lingjiawang511/printer_tag_device/WL1800-E-D001-PrinterC Rev.2.0 位号清单.xls

WL1800-E-D001-PrinterC Rev.2.0 位号清单
序号 | 封装 | 名称 | 数量 | 位号
1 | 0805 | 0.1uF(104) | 65 | C4, C9, C10, C11, C20, C33,C34, C35, C38, C39, C40, C41,C42,C45, C46, C48, C51, C53, C54,C55,C56, C57, C58, C59, C60, C61,C62,C63, C64, C65, C66, C67, C74,C75,C76, C77, C79, C81, C82, C83, C84, C86 (正面) C2, C6, C30, C31, C32,C36,C37, C43, C44, C47, C49, C50,C52,C68, C69, C70, C71, C72, C73, C78, C80, C85, C87 （背面）
2 | 0805 | 20pF | 2 | C12, C13
3 | 0805 | 1K | 20 | R2, R3, R14, R16, R24, R25, R27, R33, R52, R54, R64, R66, R68, R74, R77, R78, R81, R82, R85, R86
4 | 0805 | 2.2K | 30 | R13, R15, R17, R22, R23, R26, R32, R34, R40, R42, R44, R46, R49, R50, R51, R53, R63, R65, R67, R73, R75, R76, R79, R80, R83, R84, R87, R92, R95, R100
5 | 0805 | 10K | 45 | R1, R4, R6, R7, R18, R19, R20, R21, R28, R29, R30, R31, R36, R41, R43, R45, R47, R55, R56, R57, R58, R59, R60, R61, R62, R69, R70, R71, R72, R88, R89, R90, R91, R93, R94, R96, R97, R98, R99, R101, R102(正面) R35, R37, R38, R39（背面）
6 | 0805 | 220R | 1 | R48
7 | 0805 | 1M | 1 | R5
8 | 0805 | LED红 | 2 | LED1,LED2
9 | 0805 | LED绿 | 1 | LED4
10 | 直插 | 自恢复保险丝 C30UF500 | 1 | F1
11 | DO-214AC | SS34 | 2 | D3, D4
12 | 直插电容 | 470uF/35V | 1 | C3
13 | 直插电容 | 2200uF/35V | 1 | C1
14 | A壳 | 10uF(106C)/16v | 4 | C8, C22（正面） C5, C7（背面）
15 | SO14 | 74HC10 | 1 | U19
16 | SOP8 | LM293 | 8 | U11, U15, U21, U22, U24, U33, U34（正面） 'U17（背面）
17 | 直插 | 8MHZ无源晶振 | 1 | Y1
18 | 贴片 | 隔离电源B2405XT-2WR2 | 1 | U1
19 | SOT-223 | AMS1117-3.3 | 1 | U2（背面）
20 | SOP8 | CEM4435A | 10 | U27（正面） U8, U10, U12, U13, U25, U26, U28, U30, U31（背面）
21 | SOP16 | 光耦TLP280-4 | 8 | U9, U14, U16, U18, U20, U23, U29, U32
22 | 直插 | 有人K3网络模块 | 1 | U5
23 | LQFP-48 | STM32F103RCT6 | 1 | U3
24 | TO252 | FR5305 | 1 | Q1（背面）
25 | TO252 | FR4105 | 1 | Q2（背面）
26 | DIP-1.50 | 4PIN直角插座 | 1 | JP1
27 | 直插 | VH3.96-4PIN | 4 | CH1, CH4, CH5, CH11
28 | 直插 | VH3.96-3PIN | 7 | CH6, CH7, CH8, CH14, CH15, CH16, CH17
29 | 直插 | VH3.96-2PIN | 3 | CH9, CH10, CH13
30 | 直插 | VH3.96-6PIN | 3 | CH3, CH12, CH18
31
32
33
 |  |  | 228
