lingjiawang511/printer_tag_device/BOM For Me.xlsx

Sheet: BOM Report
Bill of Materials |  |  | Field=Title
Source Data From: |  | Field=DataSourceFileName
Project: |  | Field=ProjectFileName
Variant: |  | Field=VariantName
Creation Date: | Field=ReportDate | Field=ReportTime
Print Date: | 2017-03-17 | 17:10:34
Item # | Column=Footprint | Column=Comment | Column=Designator | Column=Value | Column=Quantity
1
2
3
 |  |  |  |  | 0
Approved |  | Notes

Sheet: Project Information
Project Full Path | Field=ProjectFullPath
Project Filename | Field=ProjectFileName
Variant Name | Field=VariantName
Data-Source Filename | Field=DataSourceFileName
Data-Source Full Path | Field=DataSourceFullPath
Title | Field=Title
Total Quantity | Field=TotalQuantity
Report Time | Field=ReportTime
Report Date | Field=ReportDate
Report Date & Tine | Field=ReportDateTime
Output Name | Field=OutputName
Output Type | Field=OutputType
Output Generator Name | Field=GeneratorName
Output Generator Description | Field=GeneratorDescription
