lingjiawang511/printer_tag_device/hardware/printer_tag_device.xlsx

Sheet: BOM Report
Bill of Materials |  |  | Bill of Materials For Project [printer_tag_device.PrjPCB] (No PCB Document Selected)
Source Data From: |  | printer_tag_device.PrjPCB
Project: |  | printer_tag_device.PrjPCB
Variant: |  | None
Creation Date: | 2017/4/10 | 11:05:41
Print Date: | 2017-04-10 | 11:05:48
Item # | Footprint | Comment | Designator | Value | Quantity
1 | C7.8*17 | C_2200uF | C1 |  | 1
2 | 0805 | Cap | C2, C4, C6, C20, C30, C31, C35, C36, C37, C38, C39, C40, C41 | 0.1uF | 13
3 | C5*10 | C_2200uF | C3 |  | 1
4 | CAP A-3216 | Cap Pol3 | C5, C7, C8, C22 | 10uF/16V(106C) | 4
5 | 0805 | Cap | C9, C10, C11, C32, C33, C34, C42, C43, C44, C45, C46, C47, C48, C49, C50, C51, C52, C53, C54, C55, C56, C57, C58, C59, C60, C61, C62, C63, C64, C65, C66, C67, C68, C69, C70, C71, C72, C73, C74, C75, C76, C77, C78, C79, C80, C81, C82, C83, C84, C85, C86, C87 | 104 | 52
6 | 0805 | Cap | C12, C13 | 20pF | 2
7 | CH3.96-4PIN | HEADER1X4 | CH1, CH4, CH5, CH11 |  | 4
8 | CH3.96-6PIN | HEADER1X6 | CH3, CH12, CH18 |  | 3
9 | CH3.96-3PIN | HEADER1X3 | CH6, CH7, CH8, CH14, CH15, CH16, CH17 |  | 7
10 | CH3.96-2PIN | HEADER1X2 | CH9, CH10, CH13 |  | 3
11 | SMA | 1N5822(SS34) | D3, D4 |  | 2
12 | X30UF600 | X30_UF500 | F1 |  | 1
13 | CON4_1.5 | 4 HEADER | JP1 |  | 1
14 | LED-0805 |  | LED1, LED2 |  | 2
15 | LED-0805 | Ready | LED4 |  | 1
16 | pad35 | Pad | Pad1, Pad2, Pad3, Pad4 |  | 4
17 | TO-252 | FR5305 (PMOS-2) | Q1 |  | 1
18 | TO-252 | FR4105 (NMOS-2) | Q2 |  | 1
19 | 0805 | Res2 | R1, R4, R6, R7, R18, R19, R20, R21, R28, R29, R30, R31, R35, R36, R37, R38, R39, R41, R43, R45, R47, R55, R56, R57, R58, R59, R60, R61, R62, R69, R70, R71, R72, R88, R89, R90, R91, R93, R94, R96, R97, R98, R99, R101, R102 | 10K | 45
20 | 0805 | Res2 | R2, R3, R14, R16, R24, R25, R27, R33, R52, R54, R64, R66, R68, R74, R77, R78, R81, R82, R85, R86 | 1K | 20
21 | 0805 | Res2 | R5 | 1M | 1
22 | 0805 | Res2 | R13, R15, R17, R22, R23, R26, R32, R34, R40, R42, R44, R46, R49, R50, R51, R53, R63, R65, R67, R73, R75, R76, R79, R80, R83, R84, R87, R92, R95, R100 | 2.2K | 30
23 | 0805 | Res2 | R48 | 200R | 1
24 | B2405XT-2WR2 | B2405XT-2WR2 | U1 |  | 1
25 | SOT223 | AMS1117-3.3 | U2 |  | 1
26 | LQFP64 | STM32F103RBT6 | U3 |  | 1
27 | USR-K3 | USR-K3 | U5 |  | 1
28 | SOP8-OP27 | CEM4435A | U8, U10, U12, U13, U25, U26, U27, U28, U30, U31 |  | 10
29 | SO16 | TLP280-4 | U9, U14, U16, U18, U20, U23, U29, U32 |  | 8
30 | SOP8-OP27 | LM293 | U11, U15, U17, U21, U22, U24, U33, U34 |  | 8
31 | SO14 | 74HC10 | U19 |  | 1
32 | XTAL_US | 8MHz | Y1 |  | 1
 |  |  |  |  | 232
Approved |  | Notes

Sheet: Project Information
Project Full Path | G:\program\printer_tag_device\hardware\printer_tag_control\printer_tag_device.PrjPCB
Project Filename | printer_tag_device.PrjPCB
Variant Name | None
Data-Source Filename | printer_tag_device.PrjPCB
Data-Source Full Path | G:\program\printer_tag_device\hardware\printer_tag_control\printer_tag_device.PrjPCB
Title | Bill of Materials For Project [printer_tag_device.PrjPCB] (No PCB Document Selected)
Total Quantity | 232
Report Time | 11:05:41
Report Date | 2017/4/10
Report Date & Tine | 2017/4/10 11:05:41
Output Name | Bill of Materials
Output Type | BOM_PartType
Output Generator Name | BOM
Output Generator Description | Bill of Materials
