lingjiawang511/printer_tag_device/(list of files, drawings)

Other design files:
hardware/printer_tag_control/air_cylinder_control.SchDoc
hardware/printer_tag_control/belt_motor_control.SchDoc
hardware/printer_tag_control/communition.SchDoc
hardware/printer_tag_control/cpu.SchDoc
hardware/printer_tag_control/light_key_control.SchDoc
hardware/printer_tag_control/power.SchDoc
hardware/printer_tag_control/printer_control.SchDoc
hardware/printer_tag_control/printer_tag_device.PcbDoc
hardware/printer_tag_control/printer_tag_device.PrjPCB
hardware/printer_tag_control/printer_tag_device.SchDoc
hardware/printer_tag_control/roll_motorl_control.SchDoc
hardware/printer_tag_control/WL1800-E-D001-PrinterC Rev.2.0.PcbDoc
hardware/printer_tag_control/WL1800-E-D001-PrinterC Rev.2.0.PrjPCB
hardware/printer_tag_control/WL1800-E-D001-PrinterC Rev.2.0.SchDoc
