lingjiawang511/printer_tag_device/printer_mcu/include/flash.h

#ifndef __STMFLASH_H__
#define __STMFLASH_H__
#include "stm32f10x.h"

//FLASH起始地址
#define STM32_FLASH_BASE 			0x08000000     //STM32 FLASH的起始地址
#define FLASH_START_ADDR    	0X08000000
#define APP_OFFSET 					  (0x4000)		
#define FLASH_SAVE_SIZE 			(0X5000)

//用户根据自己的需要设置
#define STM32_FLASH_SIZE 512 	 		//所选STM32的FLASH容量大小(单位为K)
#define STM32_FLASH_WREN 1              //使能FLASH写入(0，不是能;1，使能)
//////////////////////////////////////////////////////////////////////////////////////////////////////

 

u16 STMFLASH_ReadHalfWord(u32 faddr);		  //读出半字  
void STMFLASH_WriteLenByte(u32 WriteAddr,u32 DataToWrite,u16 Len);	//指定地址开始写入指定长度的数据
u32 STMFLASH_ReadLenByte(u32 ReadAddr,u16 Len);						//指定地址开始读取指定长度数据
FLASH_Status STMFLASH_Write(u32 WriteAddr,u16 NumToWrite,u16 *pBuffer);		//从指定地址开始写入指定长度的数据
void STMFLASH_Read(u32 ReadAddr,u16 *pBuffer,u16 NumToRead);   		//从指定地址开始读出指定长度的数据

//测试写入
void Test_Write(u32 WriteAddr,u16 WriteData);								   
#endif
