lingjiawang511/printer_tag_device/printer_mcu/include/usart.h

#ifndef __USART_H
#define __USART_H

#include "stm32f10x.h"
#include "stdio.h"

void USART1_IRQHandler(void);	
int fputc(int ch, FILE *f);
void USART1_Putc(unsigned char c);
void USART1_Puts(char * str);
void USART1_Config(void);
void USART2_Config(void);
void USART2_Putc(unsigned char c);
void USART2_Puts(char * str);
void USART3_Config(void);
void USART3_Putc(unsigned char c);
void USART3_Puts(char * str);

void USART1_Do_Tx(void );
void USART2_Do_Tx(void );
void USART3_Do_Tx(void );
void USART1_Do_Rx(u8 rxdata);
void USART2_Do_Rx(u8 rxdata);
void USART3_Do_Rx(u8 rxdata);

#endif
