lingjiawang511/printer_tag_device/(commit log)

2017-01-23 Init Signed-off-by: lingjiawang511 <398677675@qq.com>
    [air_cylinder_control.SchDoc, belt_motor_control.SchDoc, communition.SchDoc, cpu.SchDoc, light_key_control.SchDoc, power.SchDoc, printer_control.SchDoc, printer_tag_device.PcbDoc]
2017-01-23 fix the hardware
    [cpu.SchDoc, printer_tag_device.PrjPCB]
2017-02-17 fix the hardware sch and pcb
    [air_cylinder_control.SchDoc, belt_motor_control.SchDoc, communition.SchDoc, cpu.SchDoc, light_key_control.SchDoc, power.SchDoc, printer_control.SchDoc, printer_tag_device.PcbDoc]
2017-02-17 fix the hardware with delete the nouse file
    [printer_tag_device1.PcbDoc]
2017-02-17 fix the hardware PCB
    [air_cylinder_control.SchDoc, belt_motor_control.SchDoc, cpu.SchDoc, light_key_control.SchDoc, printer_control.SchDoc, printer_tag_device.PcbDoc, roll_motorl_control.SchDoc]
2017-02-22 hardware: fix the sch and PCB
    [communition.SchDoc, cpu.SchDoc, printer_tag_device.PcbDoc]
2017-02-22 hardware: fix the PCB
    [printer_tag_device.PcbDoc]
2017-02-23 software:fix the program project
    [HeadType.h, LOCK.C, TIM.C, beep.c, beep.h, belt.c, belt.h]
2017-02-27 software: printer program and the test program
2017-03-01 software and hardware: fix the roll paper control and the light and key control
    [belt_motor_control.SchDoc, printer_tag_device.PcbDoc, roll_motorl_control.SchDoc]
2017-03-02 printer software:fix the the printer and the air cylinder program
    [HeadType.h, air_cylinder.c, air_cylinder.h, exti.c, main.c, printer.h]
2017-03-02 printer software: add the communication program
2017-03-07 printer software: fix the printer control and the air control
    [LOCK.C, TIM.C, air_cylinder.c, air_cylinder.h, baffle.c, beep.c, belt.c, communication.c]
2017-03-08 printer software: fix the printer and air cylinder and the device and the light
    [HeadType.h, air_cylinder.c, belt.h, exti.c, key_and_light.c, main.c, roll_paper.c]
2017-03-08 printer software: add the project file
2017-03-08 software: printer and scanner update the communication program and fix the scanner USR file
    [HeadType.h, LOCK.C, TIM.C, air_cylinder.c, baffle.c, beep.c, belt.c, communication.c]
2017-03-08 scanner software: fix the baffle program
    [HeadType.h, baffle.c, baffle.h, main.c]
2017-03-08 hardware: fix the hardware sch and PCB
    [air_cylinder_control.SchDoc, printer_tag_device.PcbDoc, printer_tag_device.PrjPCB]
2017-03-15 printer software: add the printer program
    [printer_tag_device.PrjPCB]
2017-03-15 printer software: fix the key and the communication
    [HeadType.h, air_cylinder.c, baffle.h, belt.h, key_and_light.c, main.c]
2017-03-15 printer software:fix the baffle control
    [baffle.c]
2017-03-16 printer software:fix the key starting mode and the err mode
    [baffle.c, key_and_light.c]
2017-03-16 printer software: fix the device mode for the err
    [key_and_light.c, main.c, roll_paper.c]
2017-03-16 add the Altium designer BOM FOR ME
    [BOM For Me.xlsx, printer_tag_device.PcbDoc, printer_tag_device.PrjPCB]
2017-03-17 printer software: fix the communication program with add the communication protocol
    [HeadType.h, baffle.c, communication.c, exti.c, main.c]
2017-03-20 printer software: fix the communication and the baffle program
    [BOM For Me.xlsx]
2017-03-20 printer software: fix the baffle control and add the err message
    [baffle.c, main.c]
2017-03-21 printer :add the communication protocol manual
2017-04-06 printer software:fix the communication
    [cpu.SchDoc, printer_tag_device.PcbDoc, printer_tag_device.PrjPCB]
2017-04-07 printer software: fix the scanner err time mode
    [baffle.c]
2017-04-07 printer software: fix the baffle control
    [baffle.c, communication.c]
2017-04-10 hardware: remove the cpu2 and the rs232 communication,and fix the PCB
    [communition.SchDoc, cpu.SchDoc, printer_tag_device.PcbDoc, printer_tag_device.PrjPCB, printer_tag_device.xlsx]
2017-04-10 hardware: fix the PCB and add the BOM
    [WL1800-E-D001-PrinterC Rev.2.0 位号清单.xls, WL1800-E-D001-PrinterC Rev.2.0.PcbDoc, WL1800-E-D001-PrinterC Rev.2.0.PrjPCB, WL1800-E-D001-PrinterC Rev.2.0.SchDoc, WL1800-E-D001-PrinterC Rev.2.0.xlsx, air_cylinder_control.SchDoc, belt_motor_control.SchDoc, communition.SchDoc]
2017-06-02 add some file
    [WL1800-E-D001-PrinterC Rev.2.0.PcbDoc]
2017-06-06 printer software: fix the baffle sensor detection program
    [baffle.c, key_and_light.c]
2017-06-06 printer software:mask the baffle sensor control
    [roll_motorl_control.SchDoc]
2017-06-08 printer software: add the file which it is dispose fault and fix the baffle control
    [baffle.c]
2017-08-16 printer software: add the air_cylinder up err program
2017-11-24 software:add the printer restart signal control the roll paper motor
2018-01-10 software:fix the roll paper run delay
    [HeadType.h, air_cylinder.c, roll_paper.c]
2018-02-28 software: fix the exit pull dowm resistance
    [baffle.c, exti.c]
2018-02-28 software:reset the exit pull dowm resistance to pull up
    [exti.c]
2018-03-01 software:fix the printer err stop mode with the continuous three times
    [air_cylinder.c, exti.c]
2018-03-14 software:fix the baffle control logic with the PC control
    [HeadType.h, baffle.c]
2018-05-08 software:add the baffle ERR stop belt motor
2018-11-29 fix the sensor irq filter time
    [exti.c]
2018-12-27 add the light indicate device error state
    [key_and_light.c]
2019-01-13 software: fix the light indicate device error state
    [air_cylinder.c, key_and_light.c]
2019-05-07 software:add the roll paper delay time and fix the printer err bug
    [HeadType.h, air_cylinder.c, communication.c, exti.c, key_and_light.c, main.c]
2019-07-10 software:fix the air cylinder upper reach sensor backstate
    [HeadType.h, air_cylinder.c, exti.c, main.c]
2019-07-10 software:fix the air cylinder upper reach backstate filter time
2019-07-15 software:add the printer instruction book
2019-07-23 add the device fault analysis manual
2019-12-18 add the cylinder control side to side movement
2019-12-19 add the app program add add the test cylinder program
2019-12-25 add the macro define to mask the cylinder test program
2020-03-23 fix the printer end filter time and now the versions is V2.00.02
    [HeadType.h, air_cylinder.c, exti.c]
2020-03-24 fix the printer end filter time and update the project file
    [HeadType.h, air_cylinder.c, exti.c]
